saufik-ramadhan/imu-racer/docs/CREDITS.id.md

# Kredit aset

Seluruh karya seni di `assets/` berasal dari
[OpenGameArt.org](https://opengameart.org). Dua dari tiga aset berlisensi
CC-BY 3.0, yang **mewajibkan** atribusi di mana pun karya itu didistribusikan
ulang — termasuk pada game hasil build, bukan hanya di repositori ini.
Atribusi di bawah juga ditampilkan pada layar judul game.

## Car — Racer

- **Sumber:** https://opengameart.org/content/car-racer
- **Penulis:** Bahi
- **Lisensi:** [CC-BY 3.0](https://creativecommons.org/licenses/by/3.0/)
- **Berkas:** `cars_racer.svg`
- **Perubahan yang dilakukan:** dirasterkan saat dimuat, dipisah menjadi empat
  sprite berdasarkan celah kolom transparan, dan tiap sprite dipangkas ke kotak
  batasnya.

## Toon Road Texture

- **Sumber:** https://opengameart.org/content/toon-road-texture
- **Penulis:** da_st — https://www.davidstenfors.com
- **Lisensi:** [CC-BY 3.0](https://creativecommons.org/licenses/by/3.0/)
- **Permintaan atribusi dari penulisnya:** *"Please provide a link to my website
  (www.davidstenfors.com)."*
- **Berkas:** `Toon Road Texture_0.png`
- **Perubahan yang dilakukan:** diputar 90° saat dimuat agar jalannya
  membujur vertikal, lalu diubin mengikuti arah laju.

## Simple Explosion

- **Sumber:** https://opengameart.org/content/simple-explosion
- **Penulis:** NiceGraphic
- **Lisensi:** [CC0](https://creativecommons.org/publicdomain/zero/1.0/) — tidak
  mewajibkan atribusi; catatan penulisnya berbunyi *"Use, as you please."*
  Tetap dicantumkan di sini.
- **Berkas:** `sExplosion_strip3.png`
- **Perubahan yang dilakukan:** dipotong menjadi tiga frame 32×32.

## Bila Anda mem-fork proyek ini

CC-BY 3.0 meminta tiga hal: mencantumkan penulisnya, menautkan lisensinya, dan
menyatakan bahwa ada perubahan. Membiarkan `docs/CREDITS.id.md` beserta baris
kredit di layar judul tetap utuh sudah memenuhi ketiganya. Bila Anda menghapus
kredit dari antarmuka, aset CC-BY-nya juga harus ikut dihapus.

Kode proyek ini sendiri berlisensi MIT, dan itu hal terpisah — lihat
[`LICENSE`](../LICENSE).
