saufik-ramadhan/imu-racer/firmware/stm32h7/test-imu-racer.ioc

Mcu.UserName=STM32H7A3ZITxQ
PC14-OSC32_IN.GPIO_Label=OSC32_IN
PC14-OSC32_IN.Signal=RCC_OSC32_IN
PC15-OSC32_OUT.GPIO_Label=OSC32_OUT
PC15-OSC32_OUT.Signal=RCC_OSC32_OUT
PD8.Signal=USART3_TX
PD9.Signal=USART3_RX
PE2.Signal=SPI4_SCK
PE5.Signal=SPI4_MISO
PE6.Signal=SPI4_MOSI
PF14.Signal=I2C4_SCL
PF15.Signal=I2C4_SDA
PH0-OSC_IN.GPIO_Label=PH0-MCU
PH0-OSC_IN.Signal=RCC_OSC_IN
PH1-OSC_OUT.GPIO_Label=PH1-MCU
PH1-OSC_OUT.Signal=RCC_OSC_OUT
