saufik-ramadhan/imu-racer/(commit log)

2026-08-15 Initial commit: IMU Racer
    A three.js browser racing game steered by tilting an ESP32-S3 + GY-87 board
    over Bluetooth Low Energy, through the Web Bluetooth API.
    firmware/ ESP-IDF v6.0.2 project targeting esp32s3:
    - dual I2C buses for the GY-87 and an SSD1306 OLED
    - drivers for MPU6050, HMC5883L/QMC5883L and BMP180, probing for
    whichever variant the board carries
    - NimBLE peripheral streaming tilt at 50 Hz, with barometer,
    display and logging on a slower ~240 ms sub-tick
    web/ Vite + three.js game:
    - car sprite sheet sliced at load on transparent-column gaps
    - three-lane traffic with a guaranteed-reachable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
2026-08-15 Document the live demo
    The game is now deployed at https://saufik.web.id/imu-racer/ as a copy of
    web/dist/ inside the personal-web repository. Noted in both READMEs, along
    with how to refresh it — it is a copy rather than a submodule, so it goes
    stale unless rebuilt and copied again.
2026-09-06 Add STM32H7 controller port and split firmware by target
    firmware/ now holds one folder per board. The ESP-IDF project moves to
    firmware/esp32s3 unchanged; firmware/stm32h7 is a new STM32CubeIDE project
    for the NUCLEO-H7A3ZI-Q.
    The STM32H7A3 has no radio, so the BLE GATT service is replaced by a framed
    byte stream over the ST-LINK virtual COM port, which the browser reads with
    Web Serial. The telemetry payload is byte-for-byte the BLE notification, so
    the web client parses both boards the same way. Console logging shares the
    stream: no byte of 7-bit ASCII can be the 0xA5 start marker.
    Board-side differences from the ESP32 build:
    - one I2C bus (I2C4) shared by the GY-87 and the SSD1306
    - d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
    [ble_controller.c, ble_controller.h, gy87.c, gy87.h, i2c_bus.c]
